jasoneroberts/macropad/pcb/A/placement.csv

Designator | Layer | X mm | Y mm | Rotation | Footprint | Note
C1 | Bottom | 53.05 | 78.65 | 0 | 0805 | ENC_A to GND, close to ENC1
C2 | Bottom | 61.05 | 78.65 | 0 | 0805 | ENC_B to GND, close to ENC1
C3 | Bottom | 7.00 | 76.65 | 90 | 0805 | next to J2 pin 1
D1 | Bottom | 18.95 | 50.12 | 0 | SOD-123 | cathode (bar) toward +x
D2 | Bottom | 38.00 | 50.12 | 0 | SOD-123 | cathode (bar) toward +x
D3 | Bottom | 57.05 | 50.12 | 0 | SOD-123 | cathode (bar) toward +x
D4 | Bottom | 18.95 | 31.08 | 0 | SOD-123 | cathode (bar) toward +x
D5 | Bottom | 38.00 | 31.08 | 0 | SOD-123 | cathode (bar) toward +x
D6 | Bottom | 57.05 | 31.08 | 0 | SOD-123 | cathode (bar) toward +x
D7 | Bottom | 18.95 | 12.02 | 0 | SOD-123 | cathode (bar) toward +x
D8 | Bottom | 38.00 | 12.02 | 0 | SOD-123 | cathode (bar) toward +x
D9 | Bottom | 57.05 | 12.02 | 0 | SOD-123 | cathode (bar) toward +x
D10 | Bottom | 44.55 | 112.15 | 0 | SOD-123 | knob push diode, cathode toward +x
ENC1 | Top | 57.05 | 89.65 | 0 | EC11_SW | A/C/B pins toward the front (-y), switch pins toward the back. Trim all pins flush underneath (U1 sits under it)
H1 | Both | 28.48 | 27.05 | 0 | HOLE_2.2 | already in the DXF outline
H2 | Both | 28.48 | 46.10 | 0 | HOLE_2.2 | already in the DXF outline
H3 | Both | 47.52 | 27.05 | 0 | HOLE_2.2 | already in the DXF outline
H4 | Both | 47.52 | 46.10 | 0 | HOLE_2.2 | already in the DXF outline
J1 | Bottom | 47.00 | 53.90 | 0 | JST_PH_2_V | pin 1 = BAT+
J2 | Bottom | 7.00 | 89.65 | 90 | PADS_1x8_2.54 | pin 1 (VCC) at the -y end
SW1 | Top | 18.95 | 55.62 | 0 | MX_HOTSWAP | row 0 col 0; switch pins toward +y (back), socket on the bottom
SW2 | Top | 38.00 | 55.62 | 0 | MX_HOTSWAP | row 0 col 1; switch pins toward +y (back), socket on the bottom
SW3 | Top | 57.05 | 55.62 | 0 | MX_HOTSWAP | row 0 col 2; switch pins toward +y (back), socket on the bottom
SW4 | Top | 18.95 | 36.58 | 0 | MX_HOTSWAP | row 1 col 0; switch pins toward +y (back), socket on the bottom
SW5 | Top | 38.00 | 36.58 | 0 | MX_HOTSWAP | row 1 col 1; switch pins toward +y (back), socket on the bottom
SW6 | Top | 57.05 | 36.58 | 0 | MX_HOTSWAP | row 1 col 2; switch pins toward +y (back), socket on the bottom
SW7 | Top | 18.95 | 17.52 | 0 | MX_HOTSWAP | row 2 col 0; switch pins toward +y (back), socket on the bottom
SW8 | Top | 38.00 | 17.52 | 0 | MX_HOTSWAP | row 2 col 1; switch pins toward +y (back), socket on the bottom
SW9 | Top | 57.05 | 17.52 | 0 | MX_HOTSWAP | row 2 col 2; switch pins toward +y (back), socket on the bottom
SW_PWR | Bottom | 71.30 | 73.00 | 90 | SLIDE_RA | actuator toward +x through the right wall, matches power_switch() in macropad.scad
SW_RST | Bottom | 47.00 | 79.25 | 0 | TACT_6x3.5 | only needed to recover a bricked board
TP1 | Bottom | 56.00 | 80.25 | 0 | TP_1.5 | DBG_TX
TP2 | Bottom | 58.00 | 80.25 | 0 | TP_1.5 | GND
U1 | Bottom | 56.50 | 100.25 | 0 | PRO_MICRO_24 | Mirrored by Altium on the bottom layer. USB-C end toward +y (back wall)
