jasoneroberts/macropad/pcb/C/placement.csv

Designator | Layer | X mm | Y mm | Rotation | Footprint | Note
C1 | Bottom | 61.15 | 97.95 | 0 | 0805 | ENC_A to GND, close to ENC1
C2 | Bottom | 69.15 | 97.95 | 0 | 0805 | ENC_B to GND, close to ENC1
C3 | Bottom | 5.30 | 96.63 | 90 | 0805 | next to J2 pin 1
D1 | Bottom | 17.52 | 69.17 | 0 | SOD-123 | cathode (bar) toward +x
D2 | Bottom | 36.58 | 69.17 | 0 | SOD-123 | cathode (bar) toward +x
D3 | Bottom | 55.62 | 69.17 | 0 | SOD-123 | cathode (bar) toward +x
D4 | Bottom | 74.67 | 69.17 | 0 | SOD-123 | cathode (bar) toward +x
D5 | Bottom | 17.52 | 50.12 | 0 | SOD-123 | cathode (bar) toward +x
D6 | Bottom | 36.58 | 50.12 | 0 | SOD-123 | cathode (bar) toward +x
D7 | Bottom | 55.62 | 50.12 | 0 | SOD-123 | cathode (bar) toward +x
D8 | Bottom | 74.67 | 50.12 | 0 | SOD-123 | cathode (bar) toward +x
D9 | Bottom | 17.52 | 31.08 | 0 | SOD-123 | cathode (bar) toward +x
D10 | Bottom | 36.58 | 31.08 | 0 | SOD-123 | cathode (bar) toward +x
D11 | Bottom | 55.62 | 31.08 | 0 | SOD-123 | cathode (bar) toward +x
D12 | Bottom | 74.67 | 31.08 | 0 | SOD-123 | cathode (bar) toward +x
D13 | Bottom | 17.52 | 12.02 | 0 | SOD-123 | cathode (bar) toward +x
D14 | Bottom | 36.58 | 12.02 | 0 | SOD-123 | cathode (bar) toward +x
D15 | Bottom | 55.62 | 12.02 | 0 | SOD-123 | cathode (bar) toward +x
D16 | Bottom | 74.67 | 12.02 | 0 | SOD-123 | cathode (bar) toward +x
D17 | Bottom | 60.65 | 118.95 | 0 | SOD-123 | knob push diode, cathode toward +x
ENC1 | Top | 65.15 | 108.95 | 0 | EC11_SW | A/C/B pins toward the front (-y), switch pins toward the back. Trim all pins flush underneath (U1 sits under it)
H1 | Both | 27.05 | 27.05 | 0 | HOLE_2.2 | already in the DXF outline
H2 | Both | 27.05 | 65.15 | 0 | HOLE_2.2 | already in the DXF outline
H3 | Both | 65.15 | 27.05 | 0 | HOLE_2.2 | already in the DXF outline
H4 | Both | 65.15 | 65.15 | 0 | HOLE_2.2 | already in the DXF outline
J1 | Bottom | 50.80 | 84.45 | 0 | JST_PH_2_V | pin 1 = BAT+
J2 | Bottom | 5.30 | 109.63 | 90 | PADS_1x8_2.54 | pin 1 (VCC) at the -y end
SW1 | Top | 17.52 | 74.67 | 0 | MX_HOTSWAP | row 0 col 0; switch pins toward +y (back), socket on the bottom
SW2 | Top | 36.58 | 74.67 | 0 | MX_HOTSWAP | row 0 col 1; switch pins toward +y (back), socket on the bottom
SW3 | Top | 55.62 | 74.67 | 0 | MX_HOTSWAP | row 0 col 2; switch pins toward +y (back), socket on the bottom
SW4 | Top | 74.67 | 74.67 | 0 | MX_HOTSWAP | row 0 col 3; switch pins toward +y (back), socket on the bottom
SW5 | Top | 17.52 | 55.62 | 0 | MX_HOTSWAP | row 1 col 0; switch pins toward +y (back), socket on the bottom
SW6 | Top | 36.58 | 55.62 | 0 | MX_HOTSWAP | row 1 col 1; switch pins toward +y (back), socket on the bottom
SW7 | Top | 55.62 | 55.62 | 0 | MX_HOTSWAP | row 1 col 2; switch pins toward +y (back), socket on the bottom
SW8 | Top | 74.67 | 55.62 | 0 | MX_HOTSWAP | row 1 col 3; switch pins toward +y (back), socket on the bottom
SW9 | Top | 17.52 | 36.58 | 0 | MX_HOTSWAP | row 2 col 0; switch pins toward +y (back), socket on the bottom
SW10 | Top | 36.58 | 36.58 | 0 | MX_HOTSWAP | row 2 col 1; switch pins toward +y (back), socket on the bottom
SW11 | Top | 55.62 | 36.58 | 0 | MX_HOTSWAP | row 2 col 2; switch pins toward +y (back), socket on the bottom
SW12 | Top | 74.67 | 36.58 | 0 | MX_HOTSWAP | row 2 col 3; switch pins toward +y (back), socket on the bottom
SW13 | Top | 17.52 | 17.52 | 0 | MX_HOTSWAP | row 3 col 0; switch pins toward +y (back), socket on the bottom
SW14 | Top | 36.58 | 17.52 | 0 | MX_HOTSWAP | row 3 col 1; switch pins toward +y (back), socket on the bottom
SW15 | Top | 55.62 | 17.52 | 0 | MX_HOTSWAP | row 3 col 2; switch pins toward +y (back), socket on the bottom
SW16 | Top | 74.67 | 17.52 | 0 | MX_HOTSWAP | row 3 col 3; switch pins toward +y (back), socket on the bottom
SW_PWR | Bottom | 87.50 | 94.00 | 90 | SLIDE_RA | actuator toward +x through the right wall, matches power_switch() in macropad.scad
SW_RST | Bottom | 59.00 | 129.80 | 0 | TACT_6x3.5 | only needed to recover a bricked board
TP1 | Bottom | 66.00 | 99.30 | 0 | TP_1.5 | DBG_TX
TP2 | Bottom | 77.00 | 100.80 | 0 | TP_1.5 | GND
U1 | Bottom | 73.00 | 119.80 | 0 | PRO_MICRO_24 | Mirrored by Altium on the bottom layer. USB-C end toward +y (back wall)
