jasoneroberts/macropad/dxf/pcb_outline_A.dxf

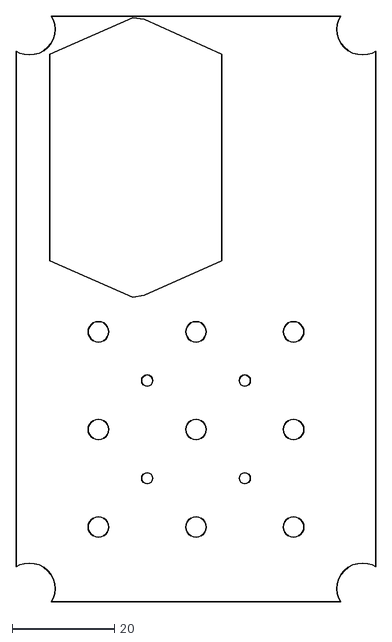
[picture p1: CAD file, 2026-10-21]
dxf/pcb_outline_A.dxf
70.2 x 114.4
