jasoneroberts/macropad/pcb/B/pcb_outline.dxf

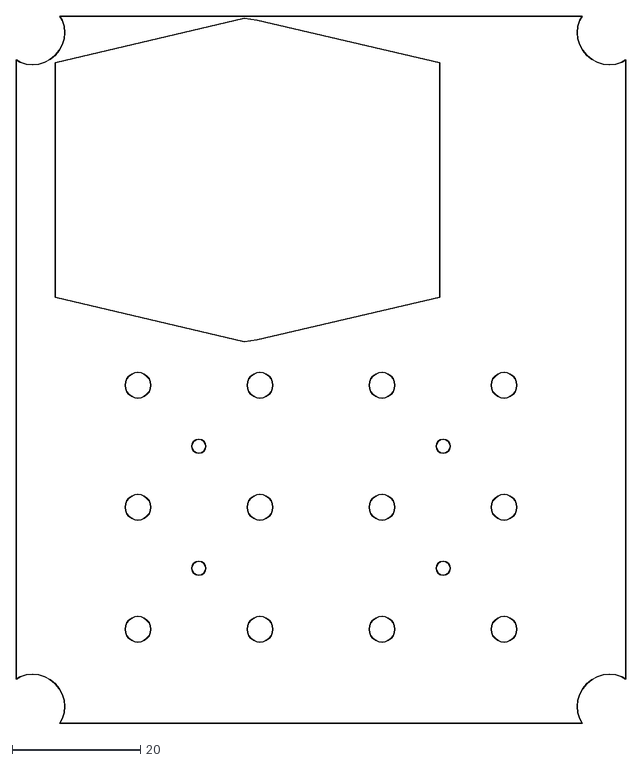
[picture p2: CAD file, 2026-10-21]
pcb/B/pcb_outline.dxf
95.2 x 110.4
