jasoneroberts/macropad/pcb/C/pcb_outline.dxf

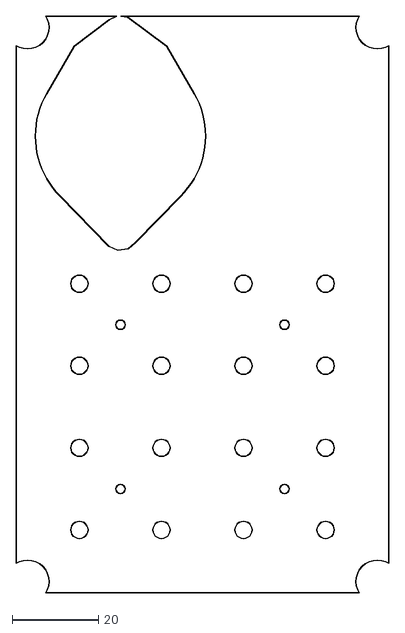
[picture p3: CAD file, 2026-10-21]
pcb/C/pcb_outline.dxf
86.4 x 133.9
