jasoneroberts/macropad/stl/A/print/top.stl

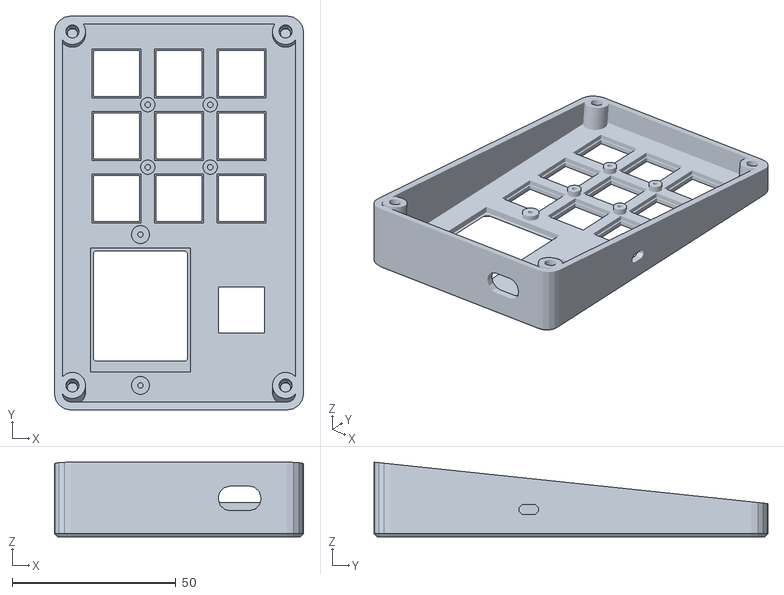
[picture p4: CAD file, 2026-10-21]
stl/A/print/top.stl
76.0 x 120.2 x 22.8
