jasoneroberts/macropad/stl/B/print/bottom.stl

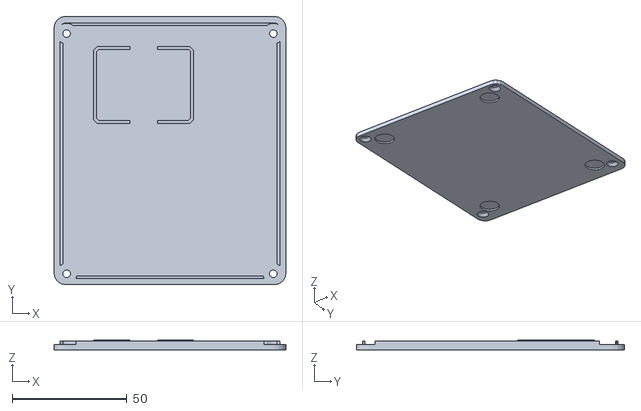
[picture p5: CAD file, 2026-10-21]
stl/B/print/bottom.stl
101.0 x 116.8 x 4.39
