jasoneroberts/macropad/stl/C/print/knob.stl

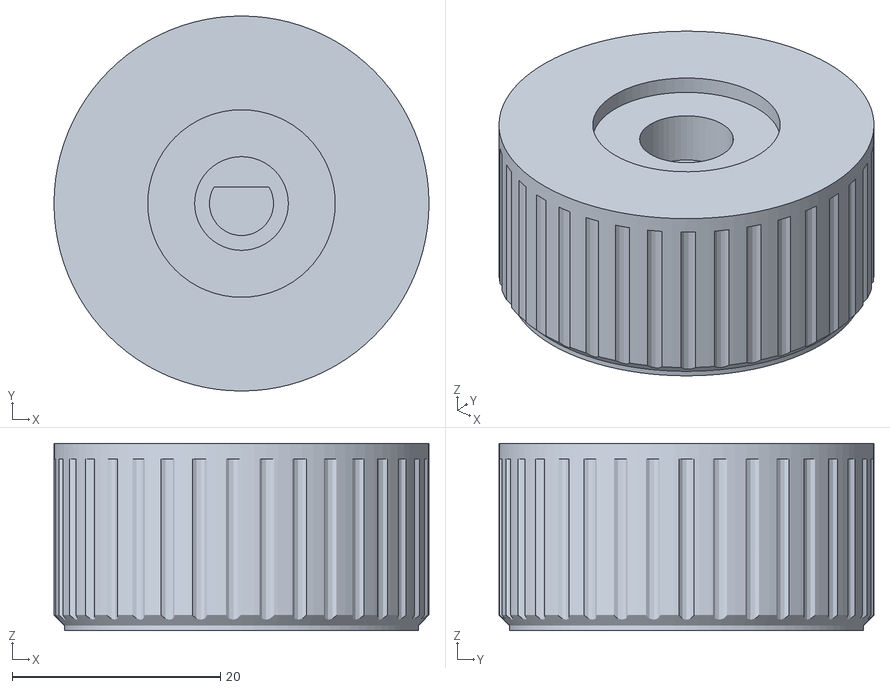
[picture p6: CAD file, 2026-10-21]
stl/C/print/knob.stl
36.0 x 36.0 x 18.0
