jasoneroberts/macropad/stl/test_coupon.stl

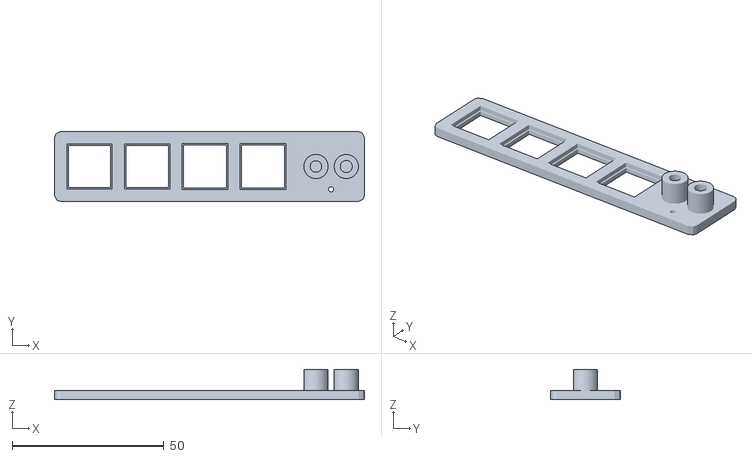
[picture p7: CAD file, 2026-10-21]
stl/test_coupon.stl
102.2 x 23.1 x 10.0
