jasoneroberts/macropad/stl/A/print/clamp.stl

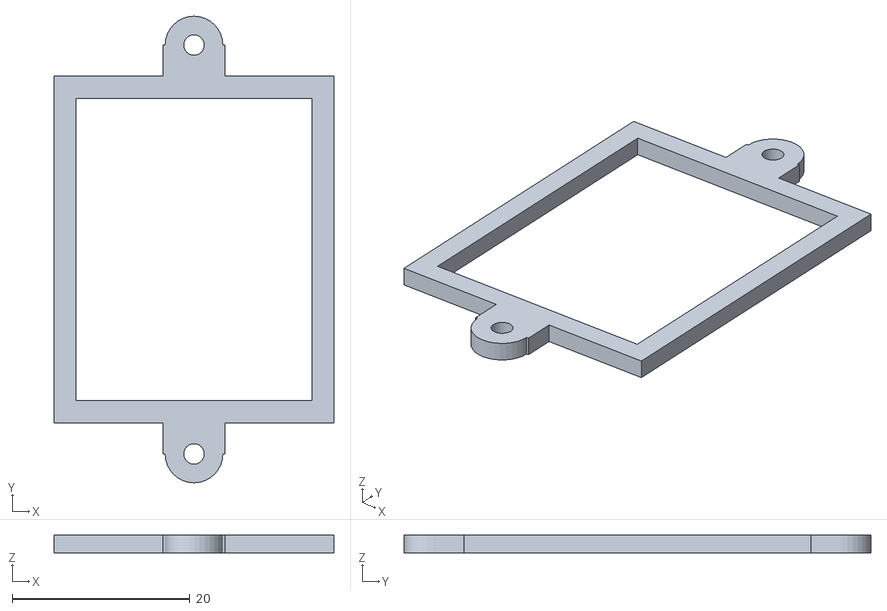
[picture p8: CAD file, 2026-10-21]
stl/A/print/clamp.stl
31.5 x 52.5 x 2.00
