jasoneroberts/macropad/stl/B/print/knob.stl

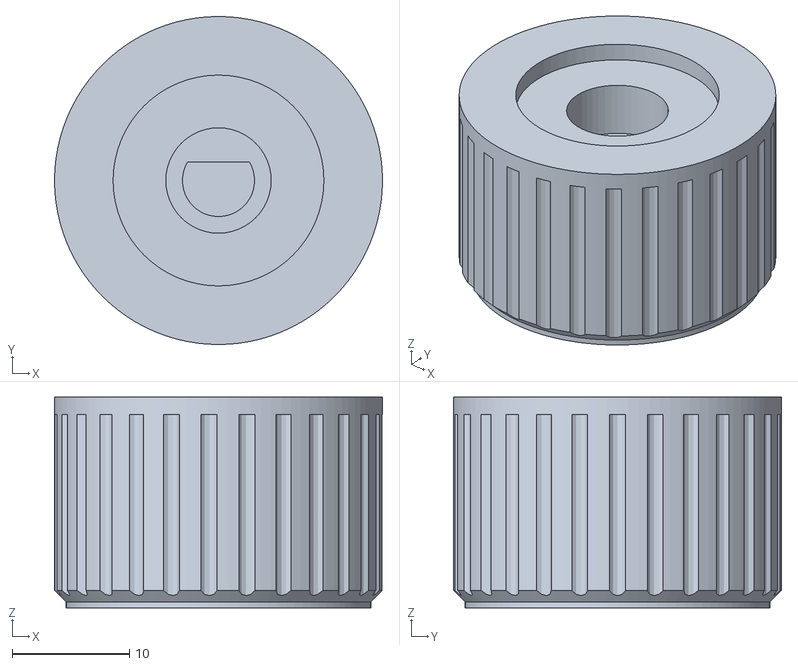
[picture p9: CAD file, 2026-10-21]
stl/B/print/knob.stl
28.0 x 28.0 x 18.0
