jasoneroberts/macropad/stl/C/print/bottom.stl

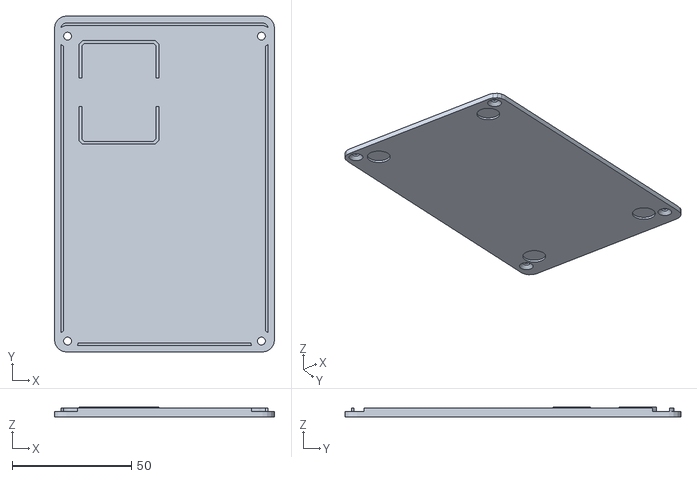
[picture p10: CAD file, 2026-10-21]
stl/C/print/bottom.stl
92.2 x 140.7 x 4.39
