jasoneroberts/macropad/stl/A/print/knob.stl

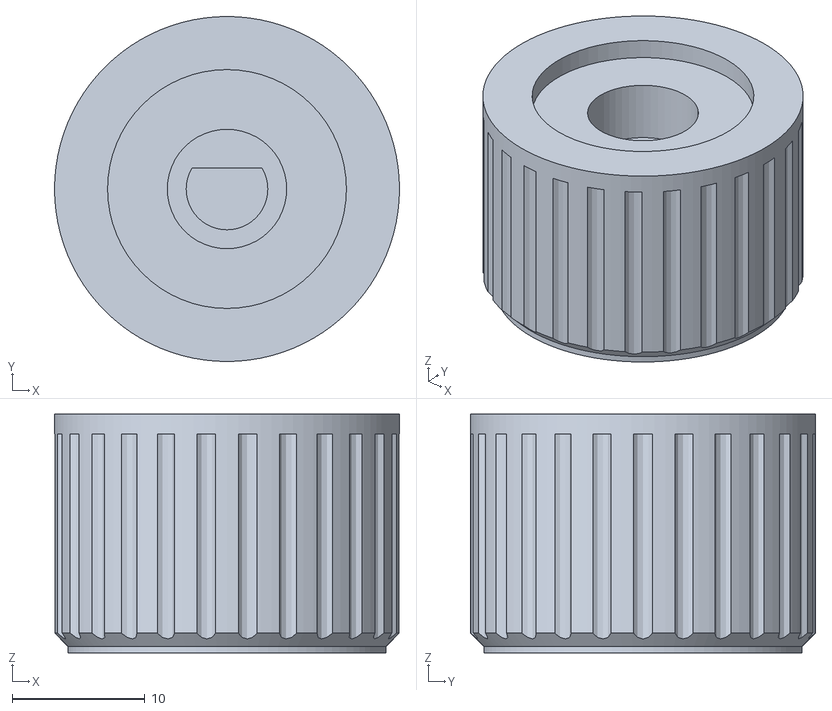
[picture p11: CAD file, 2026-10-21]
stl/A/print/knob.stl
26.0 x 26.0 x 18.0
