jasoneroberts/macropad/stl/B/print/clamp.stl

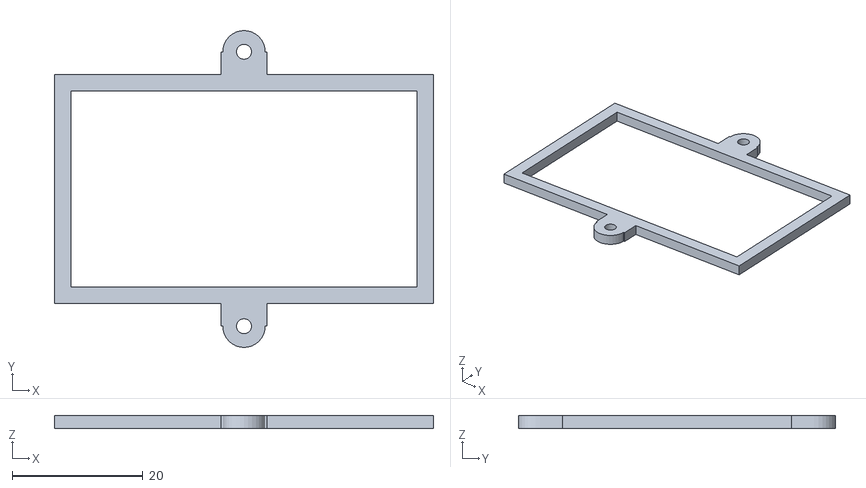
[picture p12: CAD file, 2026-10-21]
stl/B/print/clamp.stl
58.0 x 48.5 x 2.00
