jasoneroberts/macropad/stl/C/print/clamp.stl

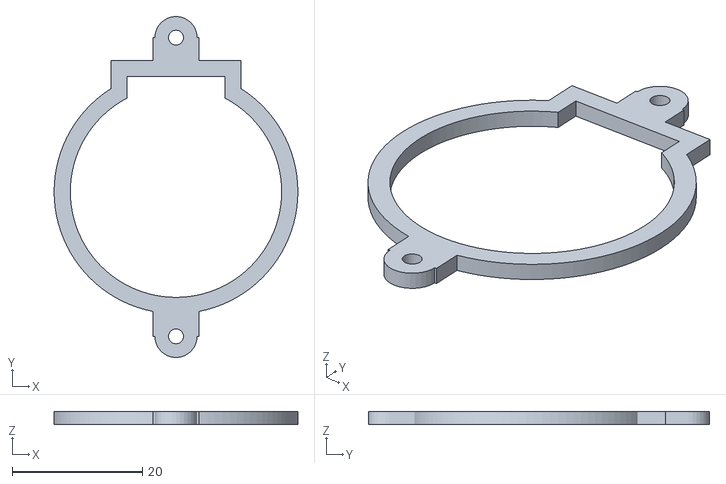
[picture p13: CAD file, 2026-10-21]
stl/C/print/clamp.stl
37.5 x 52.5 x 2.00
