jasoneroberts/macropad/stl/A/print/bottom.stl

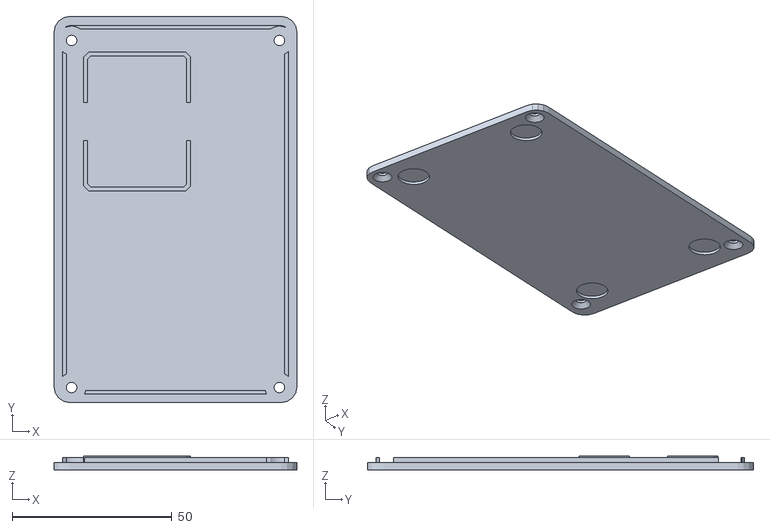
[picture p14: CAD file, 2026-10-21]
stl/A/print/bottom.stl
76.0 x 120.8 x 4.39
