jasoneroberts/macropad/stl/B/print/top.stl

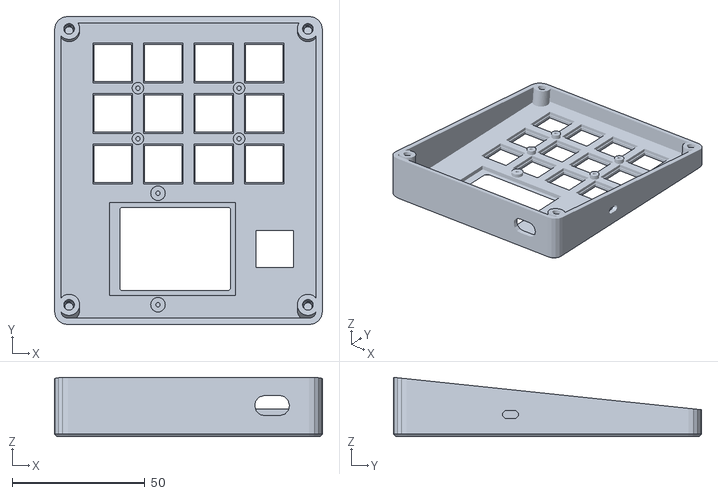
[picture p15: CAD file, 2026-10-21]
stl/B/print/top.stl
101.0 x 116.2 x 22.4
