jasoneroberts/macropad/stl/C/print/top.stl

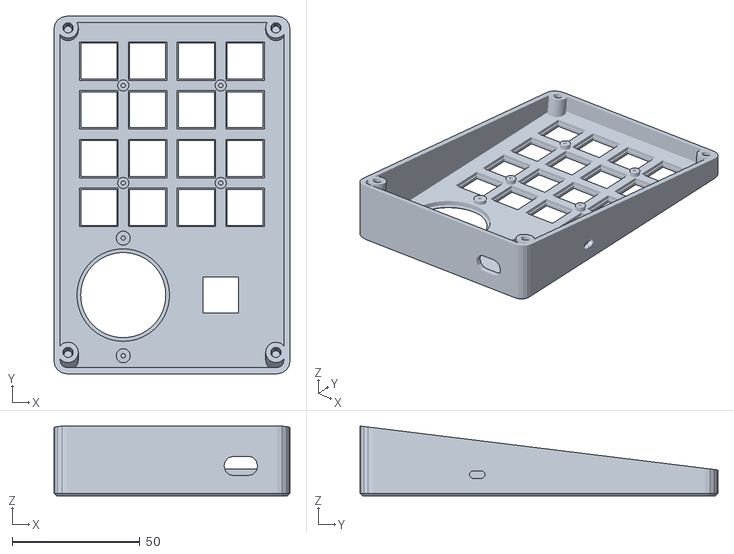
[picture p16: CAD file, 2026-10-21]
stl/C/print/top.stl
92.2 x 139.7 x 27.3
