jasoneroberts/macropad/(commit log)

2026-10-21 Add the macropad: case model, firmware and PCB files
    Moves the macropad work into its own repo:
    - scad/ parametric case for concepts A, B and C, with printable STLs,
    PCB outline DXFs, dimension reports and drawings (tools/build.py,
    tools/drawings.py, tools/make_page.py)
    - firmware/ Zephyr / NCS v3.3.0 app for the nRF52840 DK and the SuperMini
    nRF52840: key matrix, EC11 knob, LVGL tiles on an SPI LCD, USB and
    Bluetooth HID, battery level; concept B images in firmware/prebuilt/
    - pcb/ generator and per-concept BOM, netlist and placement for Altium
    - SHOPPING.md for concept B, CLAUDE.md, upstream licence texts
    - CI that builds all six firmware variants with tools/build_firmware.sh
    Co-A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
    [BOM.csv, bottom.stl, clamp.stl, connections.csv, knob.stl, macropad.scad, pcb_outline.dxf, pcb_outline_A.dxf]
2026-10-26 Shopping list: one AliExpress basket for concept B
    Delivery from RS, Farnell, Mouser or DigiKey costs more than the small
    parts, so the list is now a single AliExpress basket: quantities, search
    terms, what to check on each listing (including the encoder's 20 detents /
    20 pulses, which the firmware's quadrature decoding expects, and the
    Waveshare board size the case is built around) and rough GBP prices,
    marked as unchecked. The PCB and filament stay out of the basket.
    Claude-Session: https://claude.ai/code/session_012HVEoSHmsKUanXbKTUN9xF
